rafaelff/pendulo/README.md

# Pêndulo invertido
Trabalho de Conclusão de Curso apresentado à Faculdade de Talentos Humanos – FACTHUS, como requisito parcial de obtenção de título de bacharel em Engenharia Mecânica.

### Resumo
Este artigo apresenta as etapas de construção de um pêndulo invertido a partir de peças adaptadas de uma impressora HP Deskjet 1000. Foi utilizada uma placa Arduino Due e aplicado um controlador proporcional integral derivativo (Controlador PID) para o controle e estabilização do sistema. É demonstrado também um método para a definição dos parâmetros do controlador e a resposta do conjunto aos parâmetros definidos. Concluiu-se que é possível a construção de um pêndulo invertido de baixo custo através da reutilização de componentes eletrônicos descartados e que a placa Arduino Due atende satisfatoriamente aos requisitos propostos. O controlador PID apresentou bons resultados frente a pequenas perturbações, porém ao se deparar com variações maiores este não foi o suficiente para efetuar o controle do sistema.

### Lista de arquivos
- **Artigo científico - Pêndulo invertido.pdf**: Trabalho de Conclusão de Curso apresentado
- **Banner.pptx**: Banner utilizado na defesa do TCC
- **pendulo.ino**: Código em C++ para Arduino responsável pelo controle da construção mecânica
