rafaelff/pendulo/Banner.pptx

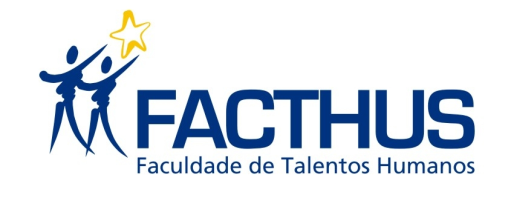
[picture p1: figure]

CURSO DE ENGENHARIA MECÂNICA
3º ENCONTRO CIENTÍFICO DAS ENGENHARIAS FACTHUS

CONSTRUÇÃO DE UM PÊNDULO INVERTIDO A PARTIR DE RESÍDUOS DE EQUIPAMENTOS ELETRÔNICOS

Rafael Faria Felix¹; Cleiton Silvano Goulart²
¹ Faculdade de Talentos Humanos, Uberaba (MG), Brasil. e-mail: rafaelfariafelix@gmail.com
²Faculdade de Talentos Humanos, Uberaba (MG), Brasil. e-mail: cleiton.goulart@facthus.edu.br

Este artigo apresenta as etapas de construção de um pêndulo invertido a partir de peças adaptadas de uma impressora HP Deskjet 1000. Foi utilizada uma placa Arduino Due e aplicado um controlador proporcional integral derivativo (Controlador PID) para o controle e estabilização do sistema. É demonstrado também um método para a definição dos parâmetros do controlador e a resposta do conjunto aos parâmetros definidos. Concluiu-se que é possível a construção de um pêndulo invertido de baixo custo através da reutilização de componentes eletrônicos descartados e que a placa Arduino Due atende satisfatoriamente aos requisitos propostos. O controlador PID apresentou bons resultados frente a pequenas perturbações, porém ao se deparar com variações maiores este não foi o suficiente para efetuar o controle do sistema.
Palavras-chave: Arduino; Controle proporcional integral derivativo; Pêndulo invertido; PID; Reutilização.

RESUMO

Método Ziegler-Nichols:
- dispensa que se conheça a equação do sistema
1. aplica-se apenas o controle proporcional (Ki = 0; Kd = 0)
2. aumenta-se a constante proporcional até se obter uma oscilação estável
3. o valor de Kp neste estado é chamado de valor crítico Su
4. encontra-se o período Pu, em segundos
5. define-se os parêmetros do controlador (tabela 1)

Controle | Kp | Ki | Kd
P | 0,5 Su | 0 | 0
PI | 0,45 Su | (Pu)/(1,2) | 0
PD | 0,8 Su | 0 | (Pu)/8
PID | 0,6 Su | (Pu)/2 | (Pu)/8

Tabela 1 – Configuração de um controlador PID de acordo com o método Ziegler-Nichols
Fonte: autor, 2017

Resposta a um controle proporcional-integral-derivativo

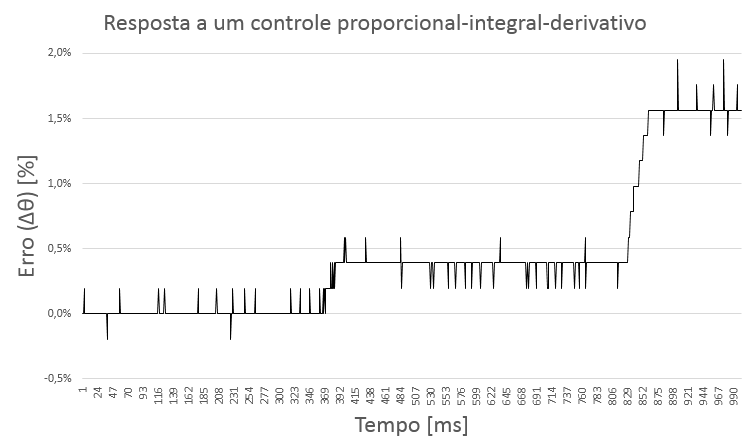
[picture p2: figure]

Kp = 6; Ki = 0,035; Kd = 0,00875

Figura 3 – Resposta do sistema aos diferentes controladores
Fonte: autor, 2017

Oscilação estável em resposta a um controle proporcional

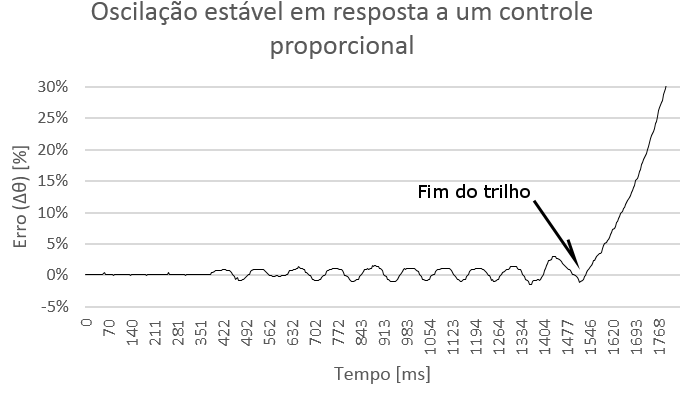
[picture p3: figure]

Kp = 10; Ki = 0; Kd = 0

Resposta a uma pequena perturbação sob um controle proporcional

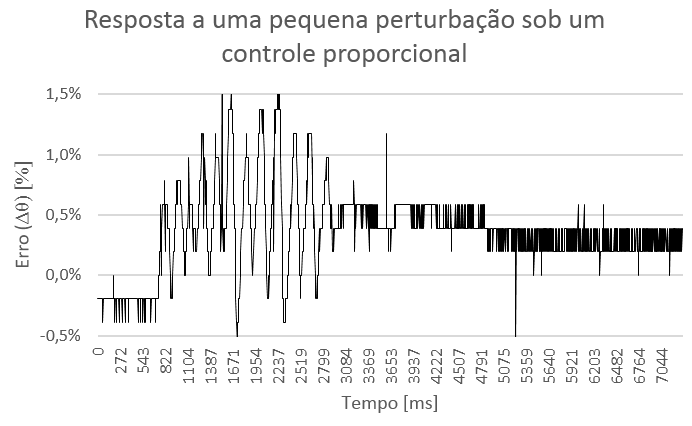
[picture p4: figure]

Kp = 5; Ki = 0; Kd = 0

Resposta a uma grande perturbação sob um controle proporcional

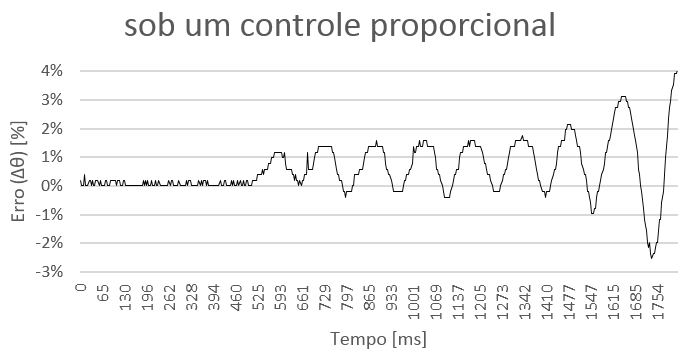
[picture p5: figure]

Kp = 5; Ki = 0; Kd = 0

Resposta a um controle proporcional-integral

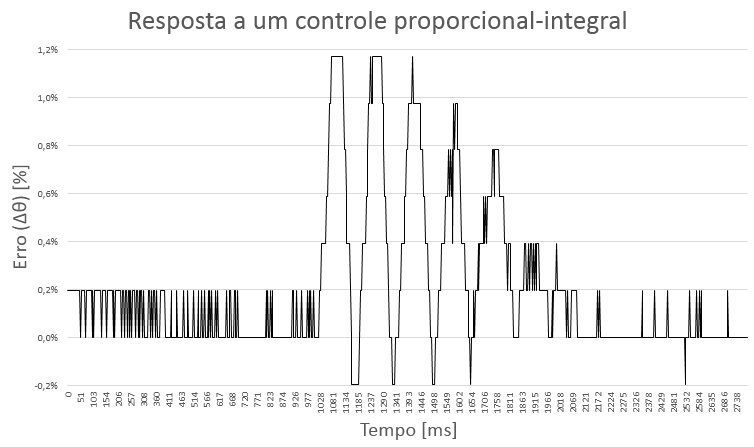
[picture p6: figure]

Kp = 4,5; Ki = 0,058; Kd = 0

Resposta a um controle proporcional-derivativo

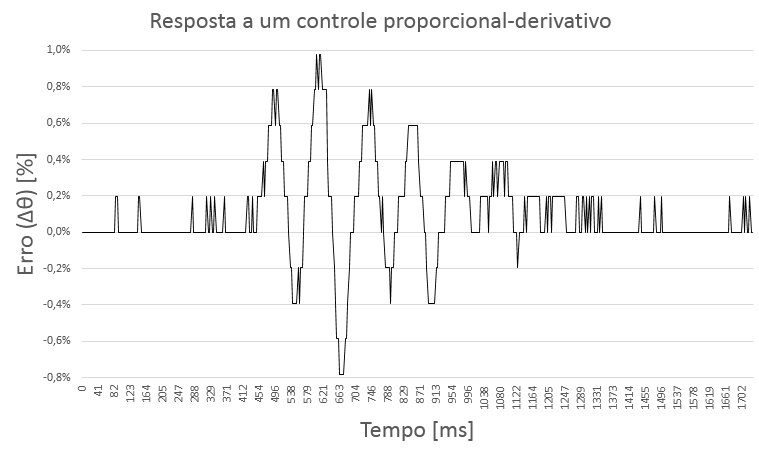
[picture p7: figure]

Kp = 8; Ki = 0; Kd = 0,00875

Ao se aplicar um controlador estritamente proporcional:
- para uma pequena perturbação o sistema estabiliza-se, porém em uma posição um pouco deslocada em relação à posição inicial
- para uma perturbação maior a amplitude do movimento aumenta até que o sistema se desestabilize
Ao se aplicar um controlador proporcional-integral:
- o deslocamento do ponto de estabilização é eliminado
- é possível estabilizar uma perturbação de maior intensidade
Ao se aplicar um controlador proporcional-derivativo:
- mais rápido – estabilidade alcançada em aproximadamente 600 milissegundos, contra aproximadamente 1000 milissegundos do controlador anterior
Ao se aplicar um controlador proporcional-integral-derivativo:
- não é possível estabilizar o sistema

É possível a construção de um pêndulo invertido com o mínimo de custo utilizando-se resíduos de equipamentos eletrônicos.
O Arduino Due apresenta desempenho satisfatório nesta aplicação, porém melhores resultados podem ser obtidos ajustando-se a resolução de leitura e escrita analógicas desta placa.
A aplicação do controlador PID apresenta bons resultados quando a variação do ângulo da barra é mínimo, porém com variações maiores os parâmetros definidos não atenderam aos requisitos.
O método Ziegler–Nichols é indicado para se obter um valor aceitável dos parâmetros quando não se conhece a equação do sistema, e melhores resultados são obtidos com o subsequente ajuste destes parâmetros.

5. ANÁLISE DOS RESULTADOS

O pêndulo invertido:
- é um sistema mecânico
- constituído de uma barra rígida sobre uma base móvel
- a base se movimenta sobre um trilho
- possui dois graus de liberdade:
  1. o ângulo entre a barra e o plano vertical (θ)
  2. a posição do carrinho em relação ao plano horizontal (x)

Figura 1 – Sistema pêndulo invertido
Fonte: autor, 2017

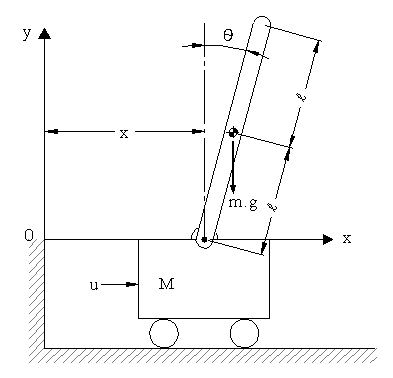
[picture p8: figure]

Pêndulo invertido:
- Variação do ângulo de um pêndulo invertido em relação às forças externas:

C1 e C2 são constantes determinadas de acordo com as propriedades físicas da construção
- sistema naturalmente instável
- para a estabilização deste sistema faz-se necessário aplicar uma técnica de controle
Controlador PID (Proporcional, Integral, Derivativo):
- define a saída u(t) a partir de um erro e(t):

u(t)= K_p e(t)+K_i ∫_0^t e(t)dt+K_d (de(t))/(dt)

- as constantes Kp, Ki e Kd regulam a resposta do sistema

2. REFERENCIAL TEÓRICO

(θ_((s)))/(U_((s)))=1/(C_1 (s+C_2 )(s−C_2 ))

1. INTRODUÇÃO

3. METODOLOGIA

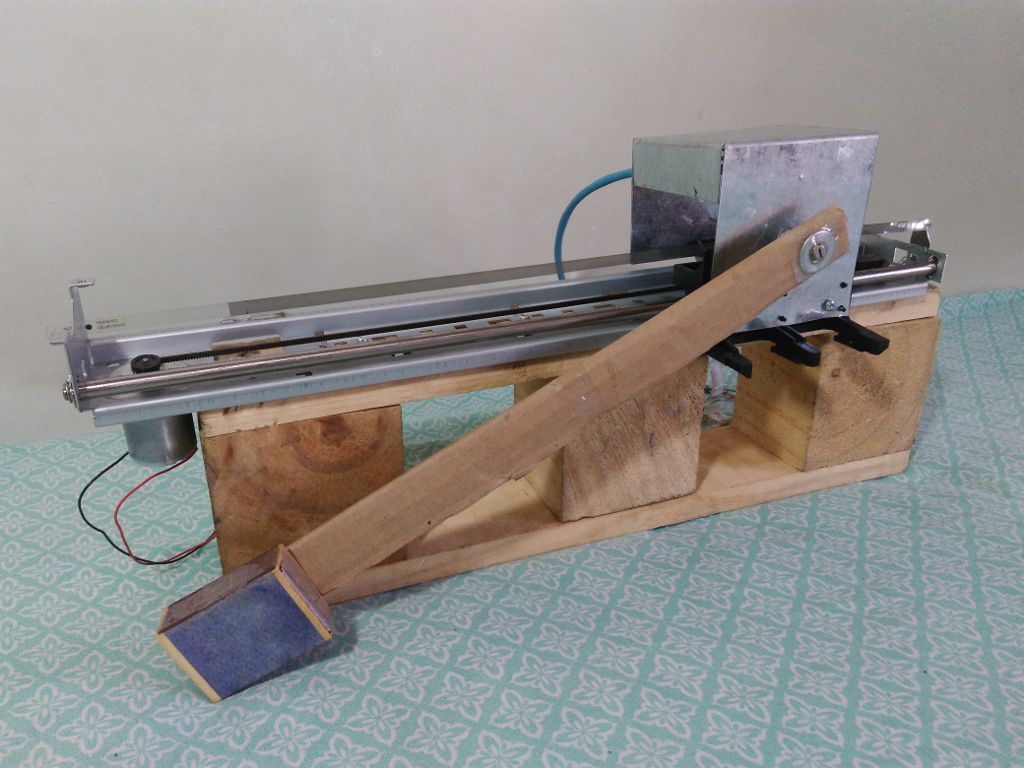
[picture p9: figure]

Figura 2 – Construção mecânica do pêndulo invertido
Fonte: autor, 2017

1. Construção mecânica
2. Programação do Arduino Due
3. Determinação de Pu e Su:
  - Pu = 0,07 segundos
  - Su = 10
4. Definição dos parâmetros PID pelo método Ziegler-Nichols
5. Teste sob diferentes combinações de controladores
6. Análise dos resultados obtidos

6. CONCLUSÕES

4. OBJETIVOS

- Construir um pêndulo invertido através de resíduos de equipamentos eletrônicos
- Verificar a aplicabilidade do Arduino Due como micro controlador de sistemas mecânicos que utilizem o princípio do pêndulo invertido
- Analisar o efeito da utilização de cada constantes do controlador PID sob o sistema
- Analisar a eficácia do método Ziegler-Nichols

DA SILVA, Ricardo Teixeira. Melhorias no kit educacional pêndulo invertido montado com REEE. Recife: Escola Politécnica de Pernambuco, 2012.
DO PRADO, Igor Ferreira. Construção e controle do sistema pêndulo invertido. Vitória da Conquista: Instituto Federal da Bahia, 2011.
OGATA, Katsuhiko. Engenharia de controle moderno. São Paulo: Pearson Prentice Hall, 5. ed., 2010.
VENDRAMINI, Gabriel; DA SILVA, Paulo Sérgio. Controle de um pêndulo invertido sobre uma plataforma móvel utilizando PID e MFAC (Model-Free Adaptive Control). Serra Negra, SP: 9th Brazilian Conference on Dynamics Control and their Applications, 2010.
ZIEGLER, John G.; NICHOLS, Nathaniel B.. Optimum settings for automatic controllers. trans. ASME 64.11 (1942).

REFERÊNCIAS

3º ENCONTRO CIENTÍFICO DAS ENGENHARIAS FACTHUS
